96boards/96boards-sensors/320030164_2x20P插件排母_规格书1.pdf

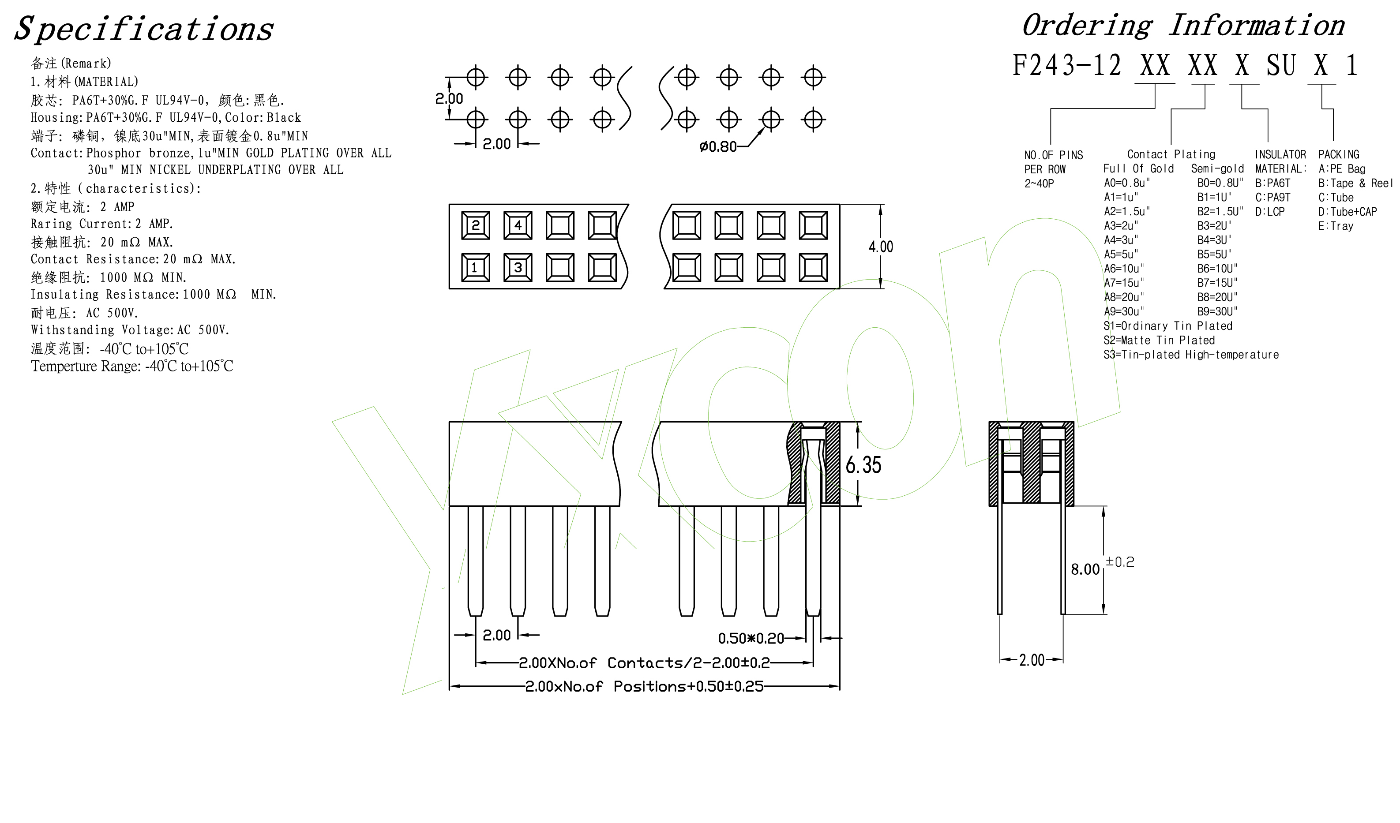
[picture p1: page 1]
