96boards/96boards-sensors/Sensors-bom-test.xlsx

Sheet: BOM
Bill of Materials
96Boards Sensors Rev C |  | Nov 29 2015
Reference | Qty | Value | Footprint | Mfr | Mfr Part # | Seeed SKU
C10 C11 | 2 | 39p | Capacitors_SMD:C_0603 | Yageo | CC0603JRNPO9BN390 | 302010126
C3 C5 C6 C7 C12 C13 C14 C15 C16 C17 | 10 | 100n | Capacitors_SMD:C_0603 | Yageo | CC0603KRX7R9BB104 | 302010138
C18 C19 C22 | 3 | 10u | Capacitors_SMD:C_0805 | Yageo | CC0805KKX5R8BB106 | 302010178
C1 C2 C4 | 3 | 2u2 | Capacitors_SMD:C_0805 | Yageo | CC0805KKX7R8BB225 | 302010148
C8 C9 | 2 | 22p | Capacitors_SMD:C_0603 | Yageo | CC0603JRNPO9BN220 | 302010143
CON1 | 1 | CONSOLE | Sensors:USB_MICRO_B_ST-USB-001E | SUNTECH | ST-USB-001E | 320010015
D1 | 1 | RESET | LEDs:LED-0603 | Everlight | 19-217-BHC-ZL1M2RY-3T | 304090045
D8 | 1 | PB5 | LEDs:LED-0603 | Everlight | 19-217-R6C-AL1M2VY-3T | 304090042
D2 | 1 | PWR | LEDs:LED-0603 | Everlight | 19-217-G7C-AN1P2-3T | 304090043
G1 D3 I2C0 P9 | 4 | GROVE | Sensors:Grove_SMD_Connector | Taifeng | 1125R-SMT-4P | 320110032
A0 A1 G2 A2 G3 G4 D4 D5 D6 D7 I2C1 P8 P13 P14 | 14 | GROVE | Sensors:Grove4P | Taifeng | 1125S-4P | 320110033
IC1 | 1 | ATMEGA328P | Housings_QFP:TQFP-32_7x7mm_Pitch0.8mm | Atmel | ATMEGA328P-AU | 310010049
P1 | 1 | CONN_02X20 | Sensors:Socket_Strip_SMD_2x20_Pitch2mm | Yxcon | F243-1220xxxSUx1 w/ 8mm Pins
P2 P5 | 2 | CONN_01X08 | Socket_Strips:Socket_Strip_Straight_1x08 | Yxcon | F185-1108A1BSYA1 | 320030003
P3 | 1 | CONN_01X10 | Socket_Strips:Socket_Strip_Straight_1x10 | Yxcon | F185-1110A1BSYA1 | 320030039
P4 | 1 | CONN_01X06 | Socket_Strips:Socket_Strip_Straight_1x06 | Yxcon | F185-1106A1BSYA1 | 320030004
P6 P7 | 2 |  | Pin_Headers:Pin_Header_Straight_2x03 | Yxcon | P125-1203A0BS116A1 | 320020003
Q1 | 1 | S8050 | Sensors:SOT-23_Seeed | JCET | S8050 | 305010017
Q2 Q3 Q4 Q5 | 4 | BSS138 | Sensors:SOT-23_Seeed |  |  | BSS138
R11 R12 | 2 | 220R | Sensors:R_0603_Seeed | Yageo | RC0603JR-07220RL | 301010163
R2 R3 R4 | 3 | 1K | Sensors:R_0603_Seeed | Yageo | RC0402JR-071KL | 301010006
R5 R7 | 2 | 620R | Sensors:R_0603_Seeed | Yageo | RC0603JR-07620RL | 301010210
R8 R10 | 2 | 22R | Sensors:R_0603_Seeed | Yageo | RC0603JR-0722RL | 301010289
R1 R6 R9 R16 R17 R18 R19 R23 R24 R25 R26 | 11 | 10K | Sensors:R_0603_Seeed | Yageo | RC0603FR-0710KL | 301010299
S1 S2 | 2 | PWR RST | kicad-gcl:SW_PUSH_B3U_1000P | Omron | B3U-1000P-2P-SMD | 311020047
U1 | 1 | CJT1117-3.3 | Sensors:SOT223 | Jiangsu Changjiang | CJT1117-3.3 | 310030097
U2 | 1 | XC6206 | Sensors:SOT-23_Seeed | Torex | XC6206P182MR | 310030016
U3 | 1 | FT230XS | Housings_SSOP:SSOP-16_3.9x4.9mm_Pitch0.635mm | FTDI | FT230XS-R | 310070030
U4 | 1 | TXB0108PW | Housings_SSOP:SSOP-20_4.4x6.5mm_Pitch0.65mm | TI | TXB0108PW | 310050024
U5 | 1 | TXS0108E | Housings_SSOP:SSOP-20_4.4x6.5mm_Pitch0.65mm | TI | TXS0108EPWR | 310050026
X1 | 1 | 16MHz | Sensors:Crystal_3.2X5_SMD | Jingpengyuan | X053201602002 | 306010054
- | 8 | M2.5 screw
- | 4 | M2.5 8mm threaded spacer
 |  |  |  | Note | Select components as appropriate for cost reductions
 |  |  |  |  | Seeed OPL components have been selected where possible

Sheet: PCB
PCB Spec
96Boards Sensors Rev C
Material | Standard FR-4
Size | 85mm x 54mm
PCB Layers | 2
Thickness | 1.6mm
Copper Weight | 1 oz
PCB Color | Green
Silkscreen | White – Topside only
Solder Mask | Via mask close
Minimum trace | Per gerber file
Minimum hole size | Per gerber file
Special requirements

Sheet: Test
Test Procedure
96Boards Sensors Rev C
Manufacturing and Test Procedure
Manufacturing
Ensure that all through hole component pins on the bottom of the board are cropped to less than 1mm
Teminology
UUT | “Unit Under Test” - Refers to the 96Boards Sensor board
96Boards Sensors Test Jig
Parts
2x20 2mm socket – Mates with UUT P6
DPDT switch
Power Supplies for +5V and +1.8V
Pogo pins or equivalent to mate with J1
Design
Create a 2x20mm header to connect to P6 wired as follows (Schematic also included below)
Pin 1 | GND
Pin 2 | GND
Pin 5 (U0 TX) | Wired to DPDT pin 6
Pin 7 (U0 RX) | Wired to DPDT pin 3
Pin 11 (U1 TX) | Wired to DPDT pin 2
Pin 13 (U1 RX) | Wired to DPDT pin 5
DPDT Pin 1 | Shorted to DPDT Pin 4
DPDT Pin 4 | Shorted to DPDT Pin 1
Pin 15 (SCL0) | Short to pin 23
Pin 17 (SDA0) | Short to pin 24
Pin 19 (SCL1) | Short to pin 25
Pin 21 (SDA1) | Short to pin 26
Pin 23 (GPIOA) | Short to pin 15
Pin 24 (GPIOB) | Short to pin 17
Pin 25 (GPIOC) | Short to pin 19
Pin 26 (GPIOD) | Short to pin 21
Pin 35 | Supply +1.8V
Pin 37 | Supply +5V
Pin 39 | GND
Pin 40 | GND
Short together the two pads on J1.
DPDT position labels
“Loopback” | DPDT position 0 – UART1 TX looped to UART1 RX
“Arduino” | DPDT position 1 – UART0 crosswired to UART1
Test Plan
a. | Select “Loopback” position on DPDT switch
b. | Connect UUT to test jig
c. | Verify UUT LED D2 (PWR) is lit
d. | Connect PC to UUT USB port (CON1)
e. | Using FTDI FT_PROG utility, flash provided template configuration into UUT's FT230X device
f. | Program Arduino UNO bootloader onto ATMEGA328 using ISP header
g. | Using serial terminal emulator on PC, verify serial data sent is looped back
h. | Select “Arduino” position on DPDT switch
I. | Verify Arduino IDE can load the “BlinkAll” sketch onto the board and it causes the PB5 LED to flash
j. | Connect GROVE LED modules to connectors D3-D7, A0-A2, A6 and I2C-AT. 10 modules in all (or use a single module to test each connector one at a time.)
Note: | Seeed's regular GROVE LED modules only use a single GPIO signal on the GROVE connector. For complete testing we would want a Grove module with 2 LEDs so that both signals get tested.
k. | Verify all LEDs on GROVE modules are flashing.
l. | Connect GROVE cable from D3 to GPIO1
m. | Connect GROVE cable from D5 to GPIO2
n. | Verify UUT LEDs are flashing: D1 & D2 (GPIOs A & B)
o. | Connect GROVE LED modules to P13 and P20
p. | Verify all LEDs on GROVE modules are flashing
FT_PROG | http://www.ftdichip.com/Support/Utilities.htm
