96boards/96boards-sensors/Sensors.pdf

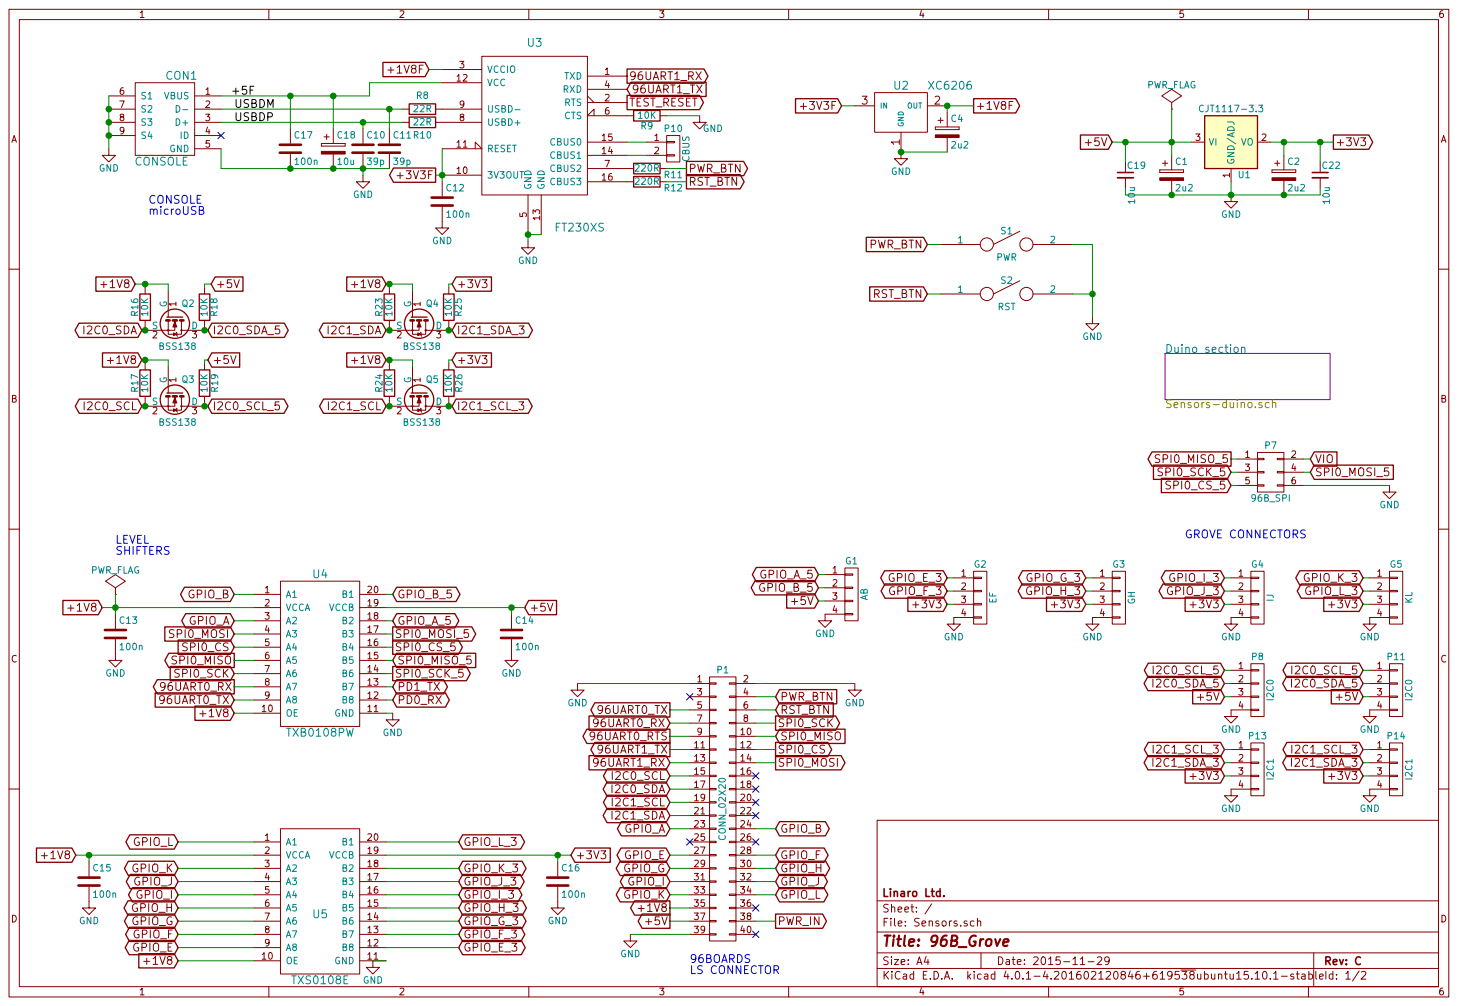
[picture p2: page 1]

I2C1_SDA_3 Duino section Sensors-duino.sch GND 1

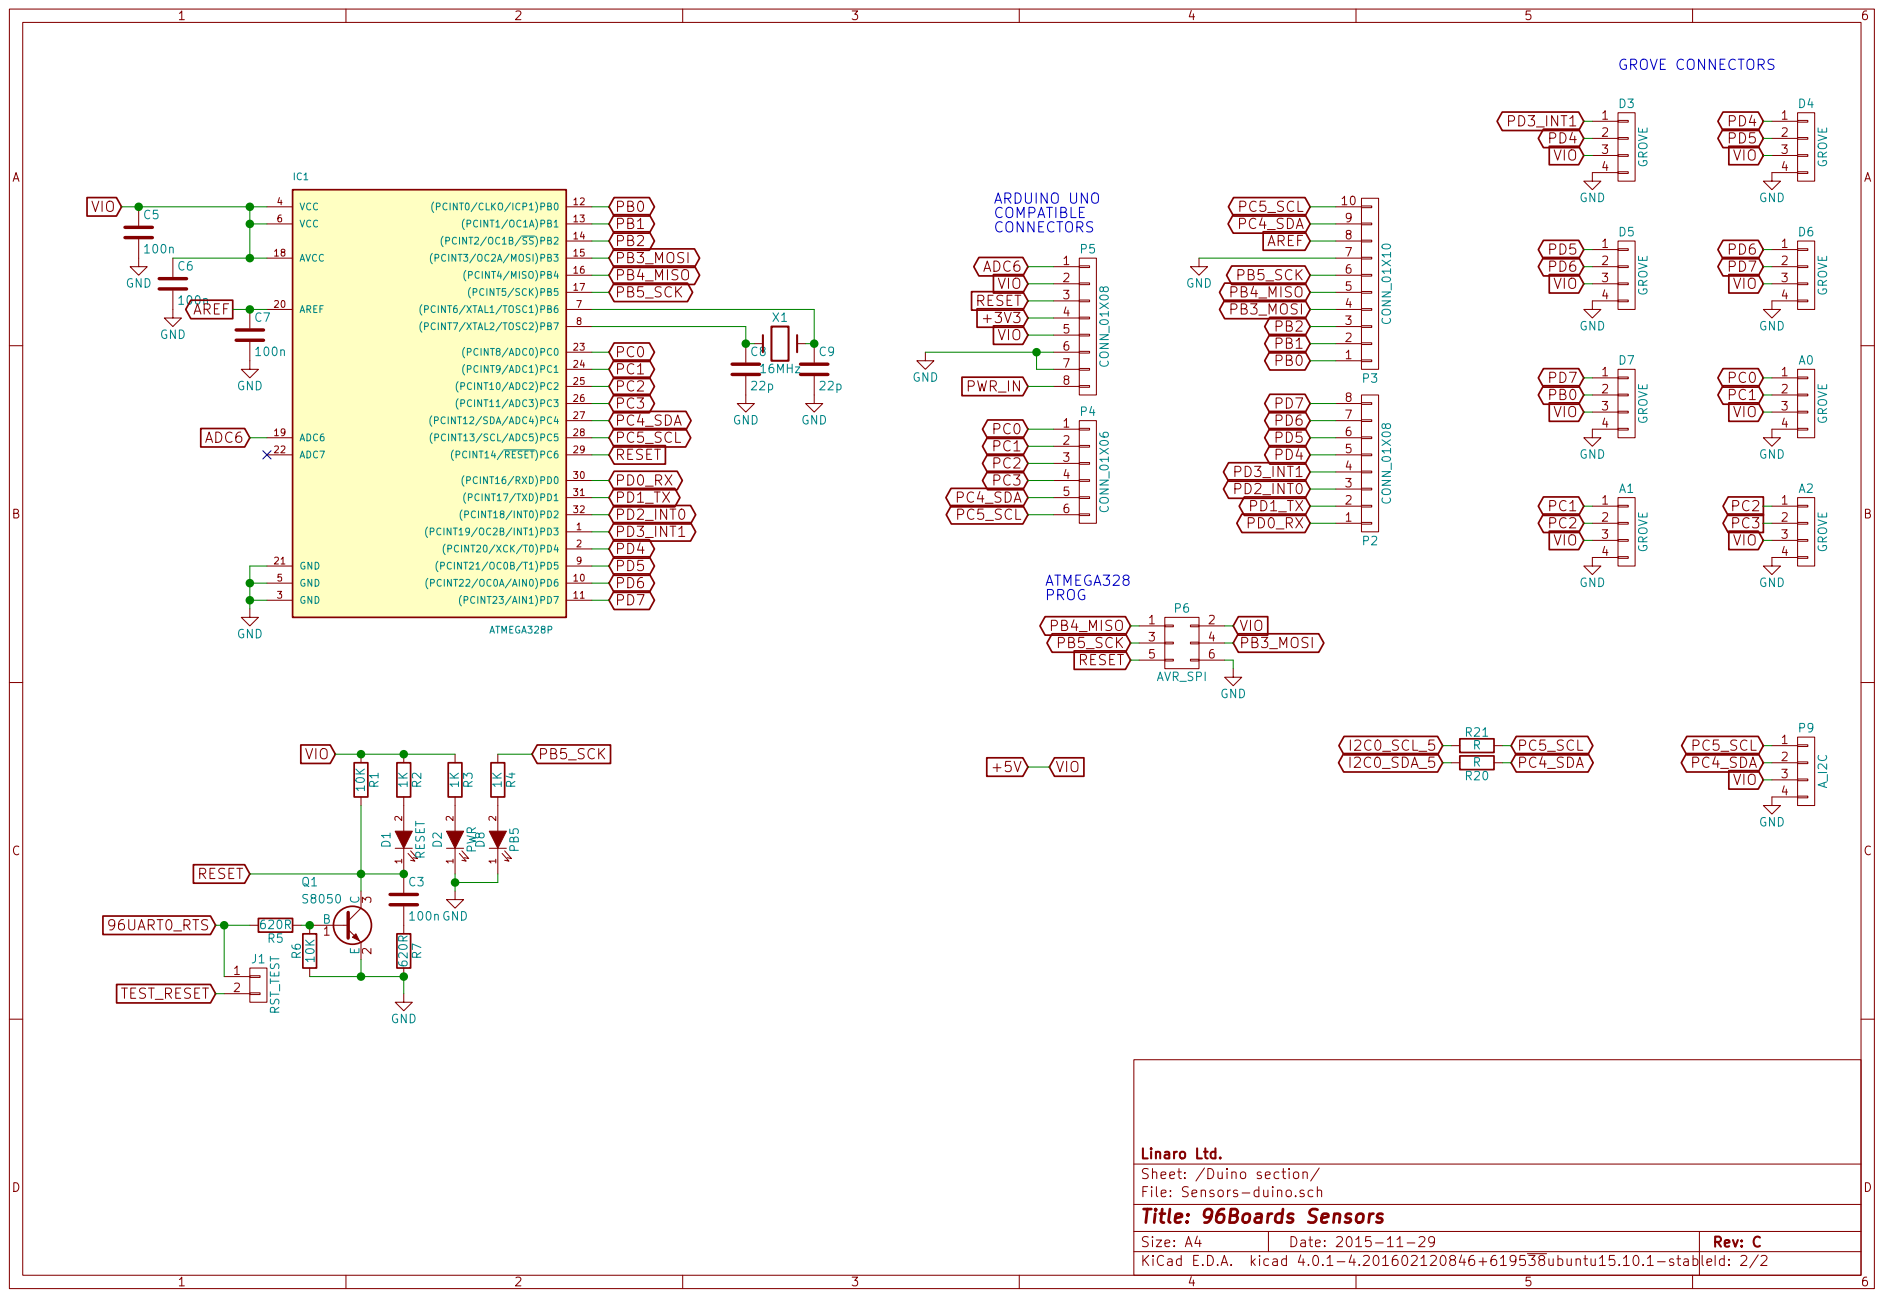
[picture p3: page 2]

File: Sensors-duino.sch Sheet: /Duino section/ Linaro Ltd.
