96boards/96boards-sensors/Sensors-layout.pdf

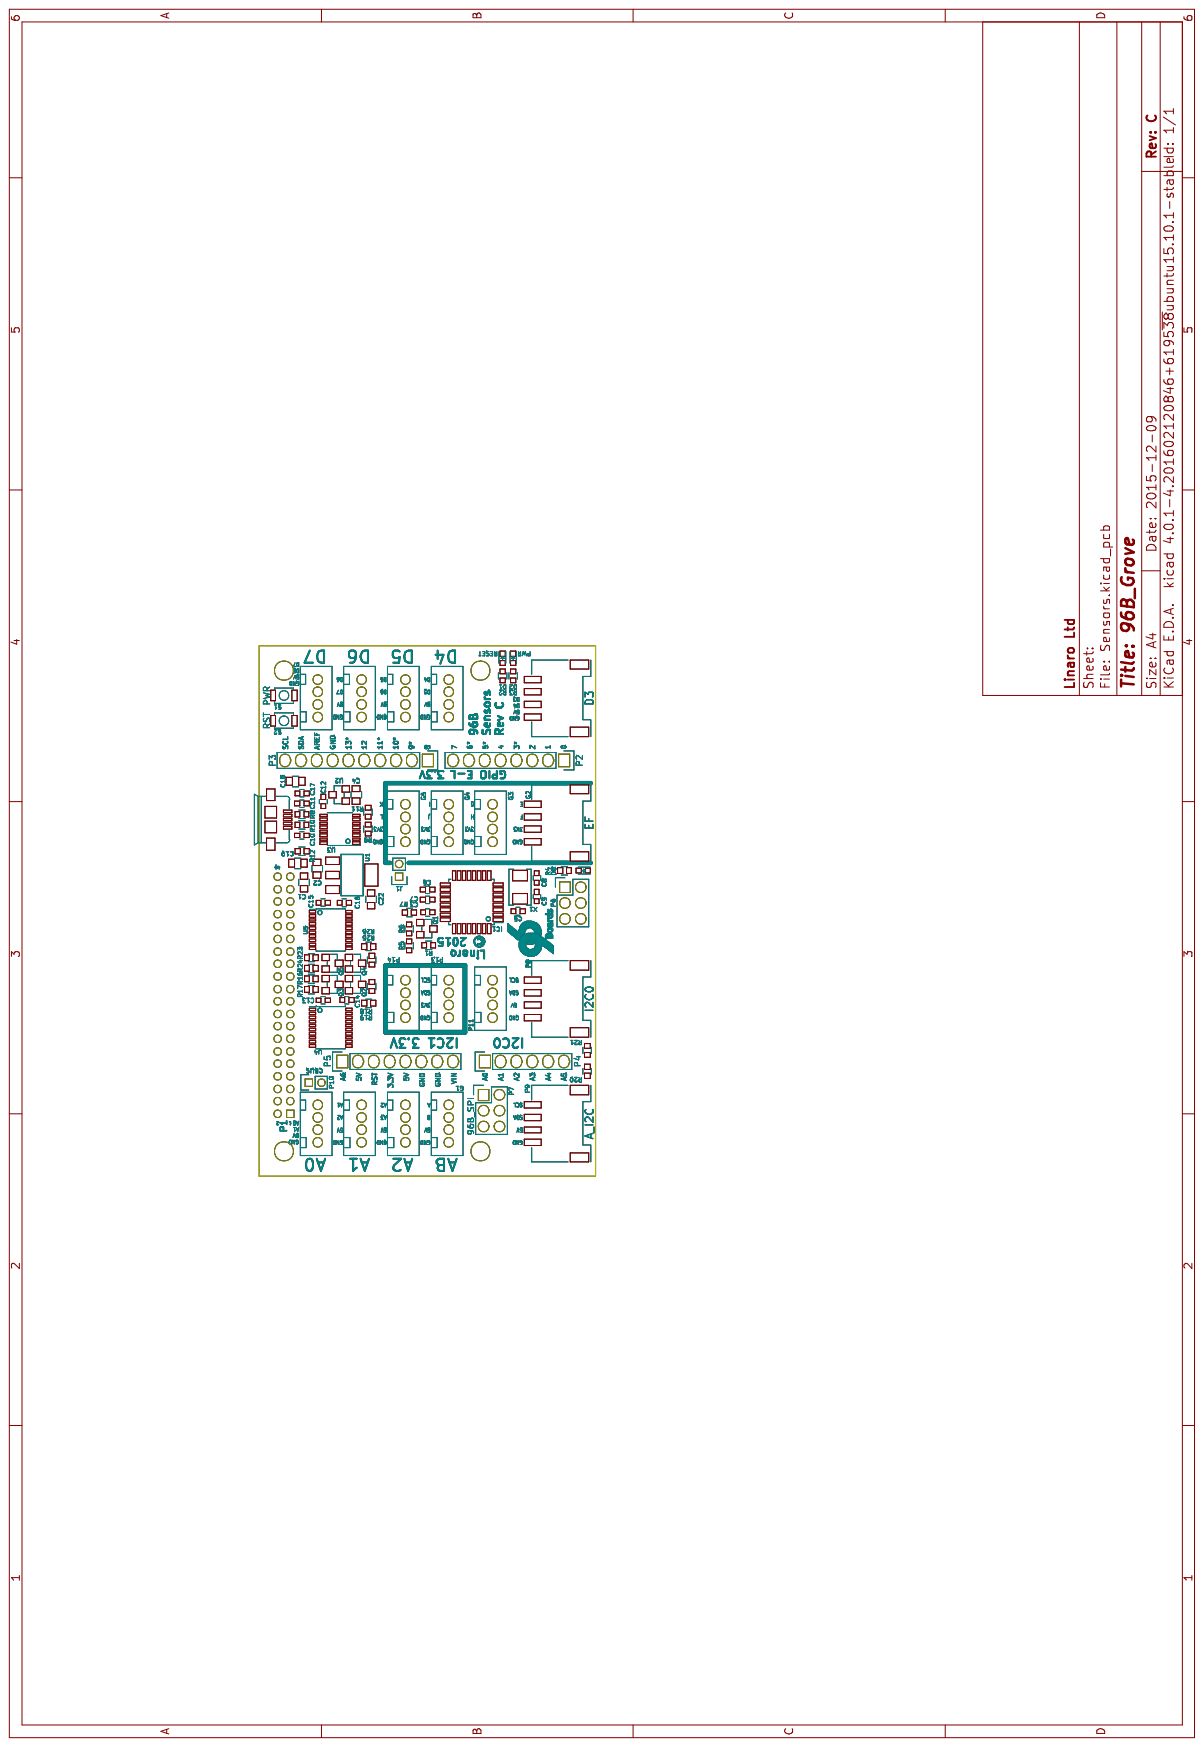
[picture p4: page 1]
