96boards/96boards-sensors/(commit log)

2015-08-12 Initial import of George's design files
    [Sensors.kicad_pcb, Sensors.sch]
2015-08-13 Add in release candidate from Aug 13
    [Sensors.kicad_pcb, Sensors.sch]
2015-08-13 Put label names into schematic
    So that updating the netlist doesn't reset all the values
    [Sensors.kicad_pcb, Sensors.sch]
2015-08-13 Put part number details into schematic
    So that the BOM can be auto-generated. I've put the values in from what
    is listed in the BOM file as provided to Seeed, but I've not verified
    that it is all correct.
    [Sensors.sch]
2015-08-14 Update Makefile to build manufacturing .zip correctly
    Needed to add the Seeed BOM and the FT230x programming file.
    [Sensors-bom-test.xlsx]
2015-08-14 Change layer selection for manufacturing outputs
    [Sensors.kicad_pcb]
2015-08-14 Make i2c busses bidirectional
    Because they are
    [Sensors.sch]
2015-08-14 Add MOSFET level shifter and split v1.8 rail
    The MOSFET provides level shifting for the RTS line. The RTS line
    provides the reset signal for the Atmel processor.
    The 1.8V rail needed to be split so that the FT230X chip works correctly
    regardless of the order the board is powered up. Without it the board
    would need to be powered up before the USB cable is plugged in.
    [Sensors.kicad_pcb, Sensors.sch]
2015-08-14 Add tool for generating collated BOM
    XSLT is not easy to figure out. This is a pretty ugly hacked up script
    to generate a BOM with all the identical components collated into a
    single line item.
2015-08-14 Fixup part numbers in schematic
    [Sensors.sch]
2015-08-15 Switch back to using a transistor for Arduino reset
    The RTS reset pulse sent by avrdude is active high, not active low, so
    switch back to a transistor circuit for doing the level shifting.
    [Sensors.kicad_pcb, Sensors.sch]
2015-08-17 Switch transistor schematic symbol to BC817
    The part is still an S8050, but we want to use the SOT-23 footprint
    instead of TO-92. The default Kicad libraries don't have a SOT-23
    version of the S8050, but it does have one for the BC817 which uses the
    same pinout. Switch the schematic symbol so that KiCad stops complaining
    about the footprint being different and needing to be "rescued"
    [Sensors.sch]
2015-08-17 Add library for project footprints.
    Adds a kicad library for the non-standard footprints used by this project
2015-08-17 Get rid of "Sensors2" library
    All of the footprints are stored in the "Sensors" library. The extra
    "Sendors2" library is no longer needed. Replace all references to it
    with "Sensors".
    [Sensors.kicad_pcb, Sensors.sch]
2015-08-17 Change resistor footprint for Seeed manufacturing
    The default resistor footprint doesn't work for Seeed. Replace with the
    footprint used on the UART board.
    [Sensors.kicad_pcb, Sensors.sch]
2015-08-17 Fix misplaced silkscreen labels
    R2 and C3 labels were in the wrong places. Fix them. Also remove an
    obsolete polarity marker on C11.
    [Sensors.kicad_pcb]
2015-08-17 Update ATMEGA label in layout file
    An earlier commit fixed an incorrect specification on the ATMEGA part
    (it specified the -M variant, but we're using the -AU variant), but the
    layout file didn't get updated. Fix it.
    [Sensors.kicad_pcb]
2015-08-17 Remove the back silkscreen from the gerber set.
    We're not printing the back silkscreen, so don't generate it.
    [Sensors.kicad_pcb]
2015-08-17 Update copper fills
    Update the copper fill. Only change should be due to the new resistor footprint.
    [Sensors.kicad_pcb]
2015-08-17 Move gerber file generation in to a subdirectory
    Putting all the gerbers into a sub directory makes is easier to clean
    out the generated files.
    [Sensors.kicad_pcb]
2015-08-17 Check in designs files as submitted to manufacturing
    [96boards-sensors-bom-test.xlsx]
2015-08-17 Add netclass for power rails
    [Sensors.kicad_pcb]
2015-08-17 Cleanup tracks and vias
    Make sure the tracks are properly connected, nicely aligned and not duplicated.
    [Sensors.kicad_pcb]
2015-08-17 Fix incorrect part specifier for 3.3V regulator
    The V3.3 regulator is a CJT1117, not an S8050
    [Sensors.kicad_pcb, Sensors.sch]
2015-08-18 Update part numbers in schematic for BOM generation
    [Sensors.sch]
2015-08-18 Respond to comments from Seeed DFM - Aug 18, 2015
    George's fixes for the issues from Seeed:
    - Add pin 1 markers to IC footprints
    - Fix fiducials solder mask size
    - Widen power rails
    - Resize logos so they don't blurr
    [Sensors.kicad_pcb]
2015-08-18 Cleanup tracks and vias
    Two minor fixups, plus perform area fill and DRC
    - Straighten crooked PB1 trace
    - Fix width on SCL trace
    [Sensors.kicad_pcb]
2015-09-04 Update test plan to be more specific
    Clarify the test plan to spell out exactly how the test jig should be
    built and specify how to program the Arduino without a 1.8V FTDI cable.
    Also add a procedure for testing the Grove connectors by using an
    Arduino test sketch on the ATMEL.
    [96boards-sensors-bom-test.xlsx]
2015-09-06 Add Arduino sketch to blink all the LEDs
    For testing. Verifies the Arduino signals.
2015-09-08 Update test program to exercise the UART
    Just in case upload doesn't work with the UART, exercise the UART using
    the test sketch.
    [BlinkAll.ino]
2015-09-08 Fix testplan for missing connector tests
    Fix the test plan to better test the Grove connectors. The A0 to A6
    Arduino pins were not getting exercised. Also, the 96B pins were not
    getting effectively tested. Update the test sketch to include the A0 to
    A6 pins, and update the testplan to match.
    [96boards-sensors-bom-test.xlsx]
2015-09-24 Remove the switch
    [Sensors.sch]
2015-10-04 Add SMD 90d Grove connector, and add model to through-hole version
2015-10-06 Rewire PB5 LED to drive high to light and use a 1K resistor
    The first rev had the LED tied to +5V, and PB5 needed to pull it low to
    light. This doesn't play well with USBTinyISP because it puts too much
    load on the line for the programmer to actually program the Arduino, and
    it is opposite to the way the led is wired on every other Arduino. Fix
    it to be consistent with the rest of the Arduino world.
    [Sensors.sch]
2015-10-06 Move the SPI connector to the correct place for Arduino
    For more compatibility with Arduino shields, the SPI connector should be
    in exactly the same place.
    [Sensors.kicad_pcb]
2015-10-06 Add labels for SPI and all the GPIOs
    No functional change, just put the labels in so that they can be used in
    a later change.
    [Sensors.sch]
2015-10-06 Remove UART Grove connectors
    The Arduino UART signals are hard-wired to the LS UART anyway, so it
    cannot really be used for any other purpose. Remove the Grove connector
    for the UART. If someone really wants to use a UART module, there is the
    option to do a soft UART.
    [Sensors.sch]
2015-10-08 Proposed rework of sensors board for revB
    Lots of changes to the schematic:
    - Replace level shifters to 8 channel variants to get more 96board IO
    available
    - Level shift the SPI signals
    - Remove two of the user LEDs
    - Add Grove connectors for additional two lines of GPIO
    - Add pull-up resistors to I2C bus
    - Rename Grove connectors to reflect the signal names
    - Choose some grove connectors for front-edge 90 degree SMD connectors
    - Add connector for FTDI CBUS[0,1] signals. May be useful for twiddling
    boot select pins
    - Add a library for components used in this design
    [Sensors.sch]
2015-10-09 Replace '/' with '_' in signal names
    KiCad gets confused when '/' is used in a signal name. The layout editor
    cuts off everything before the '/'. Replace it with underscore which
    works much better.
    [Sensors.sch]
2015-10-18 Tweak Grove connectors and create VIO rail
    Tweaks the selection of Grove connectors to match the layout of the
    board. At the same time, allow the IO voltage to be selectable between
    3.3V and 5V via a solder jumper. The Atmel will happily run at a lower
    voltage level, and an awful lot of devices run at 3.3V these days.
    [Sensors.sch]
2015-10-18 New layout for Rev B
    Lots of changes, just about everything has moved, even if just a little
    bit. New layout has far more regular placement of components.
    [Sensors.kicad_pcb]
2015-10-19 Add ADC6/7 Grove connector and test reset jumper to schematic
    Adds one more Grove connector to break out ADC6 & ADC7. At the same time
    add a jumper to allow the FTDI to reset the Arduino, which is useful for
    programming the board during manufacturing test.
    Only changes the schematic. Layout comes later
    [Sensors.sch]
2015-10-19 Layout the new Grove connector
    Adds in the new A6 Grove connector and the reset test jumper.
    [Sensors.kicad_pcb]
2015-10-20 Renumber components
    The components weren't numbered in any kind of logical way. Renumber
    them all to make it easier to find connectors when looking at the Grove
    connectors.
    [Sensors.kicad_pcb, Sensors.sch]
2015-10-20 Adjust placement of layout on sheet to be on an even mm boundary
    It's easier to check dimensions when the board origin is on an even
    boundary. It's a trivial thing, but it makes looking at the layout
    nicer.
    [Sensors.kicad_pcb]
2015-10-20 Tidy up fill zones to line up on mm boundaries
    The fill zones seemed to be pretty ragged. Neaten them up to be back 1mm
    from the edge of the board all the way around.
    [Sensors.kicad_pcb]
2015-10-20 Update silkscreen and dimension drawings
    Update all of the component label placement so that they can actually be
    read. Also update the dimensions for reference.
    [Sensors.kicad_pcb]
2015-10-20 Update design files as "rev B" and create pdfs
    [Sensors.kicad_pcb]
2015-10-20 Add labels to Grove signals
    The board is easier to use when everything is labelled.
    [Sensors.kicad_pcb]
2015-10-20 Use connector name for component references
    By using the component name as the reference (ex. A7 instead of P10)
    there can be fewer labels on the silkscreen. Where possible, change the
    connector references to the connector name.
    [Sensors.kicad_pcb, Sensors.sch]
2015-10-22 Switch to through-hole 2x20 connector
    We want to use a stackable connector on the 40pin LS connector, and
    through hole is better than SMD for building stackable boards. Switch
    the footprint to a 2mm 2x20 through-hole part.
    [Sensors.kicad_pcb]
2015-10-24 Move Arduino UNO compatible circuit onto a separate sheet
    The schematic sheet was getting really crowded. Move all of the Arduino
    section to another sheet to give some more room.
    [Sensors-duino.sch, Sensors.kicad_pcb, Sensors.sch]
2015-10-27 Add MOSFETs to switch power supply between 3.3V and 5V
    The original design just routed the power rails directly through solder
    jumper pads, but feedback from review suggested that a switch would be
    more friendly to end users. The power rails could have been routed
    directly through a physical switch, but I was concerned about noise on
    the power rails. Instead, add power supply switching by routing the 5V
    and 3.3V rails through a pair of MOSFETs to isolate them from a switch
    or jumper pads.
    [Sensors-duino.sch, Sensors.kicad_pcb, Sensors.sch]
2015-10-27 Pull i2c lines UP, not down
    The schematic was wrong. It was pulling the i2c lines down instead of
    up. Fix both the schematic and the layout.
    [Sensors-duino.sch, Sensors.kicad_pcb, Sensors.sch]
2015-10-27 Add pads for i2c pull ups on the 1.8V side
    It isn't yet known if we'll need them, but add pads for pullup resistors
    on the i2c 1.8V lines. Doing so ensures that we won't need to respin the
    board if the pullups turn out to be required.
    [Sensors-duino.sch, Sensors.kicad_pcb, Sensors.sch]
2015-10-27 Fix up silkscreen by making labels smaller
    Change all the R and C labels, plus a few more, to 0.7 point instead of
    1 to make everything less cramped.
    [Sensors.kicad_pcb, Sensors.sch]
2015-10-27 Fix DRC errors on schematic
    Fix the following problems:
    - Fix missing drive pin on VIO signal. Fixed by added PWR_FLAG component
    - Unconnected labels on GPIO G-L. Fixed by removing labels and replacing
    with no-connect
    [Sensors-duino.sch, Sensors.sch]
2015-10-27 Minor tweaks to silkscreen
    Move some stuff around and add the 96Boards and OSHW logos.
    [Sensors.kicad_pcb]
2015-10-27 Rename I2C connectors "AT-I2C" to distinguish from 96B i2c busses
    [Sensors-duino.sch, Sensors.kicad_pcb]
2015-10-27 Update the Seeed part numbers for generating the BOM
    [Sensors-duino.sch, Sensors.sch]
2015-10-28 Straighten a trace
    Trivial change. Just taking a kink out of a trace
    [Sensors.kicad_pcb]
2015-10-28 Fix errors in part number fields
    Minor changes to the part number fields, and an update to a footprint
    selection
    [Sensors-duino.sch, Sensors.sch]
2015-10-28 Swap out SOT-23 footprint on Q2 and Q3
    Seeed likes bigger pads for these parts. Swap out the footprint
    [Sensors.kicad_pcb]
2015-10-28 Add dimensions for the Arduino connectors
    [Sensors.kicad_pcb]
2015-10-28 Update the layout pdf
    [Sensors.kicad_pcb]
2015-10-28 Update design package
    [96boards-sensors-bom-test.xlsx, Sensors-bom-test.xlsx]
2015-10-29 Space out the MOSFETs better
    They were pretty close. Space them out better so that the power rail
    routing can be cleaner.
    [Sensors-bom-test.xlsx, Sensors.kicad_pcb]
2015-10-29 Change LED resistor values to 1k
    At 5V, a 620ohm resistor makes the LEDs too bright.
    [Sensors-duino.sch, Sensors.kicad_pcb, Sensors.sch]
2015-10-29 Move R13, R14, R17 & 18 to give more room for rework
    These resistors were placed very close to big components and would have
    been difficult to hand-solder or rework. Move the components to better
    locations and adjust the silkscreen to match.
    [Sensors.kicad_pcb]
2015-10-29 Add clearer pin 1 indicators on U1, U2 and U3
    The default SSOP footprint uses a long line above pin 1, but Seeed wants
    a clearer indication. A small circle at pin 1 is more traditional.
    [Sensors.kicad_pcb]
2015-11-04 Remove i2c pullups and add 22 ohm series resistors to reduce noise
    There have been all kinds of problems with noise on the i2c bus, but the
    pull up strength seems to be just fine for the bus speed that we're
    using. Remove the pull up resistors, but put in series resistors to
    reduce the effects of crosstalk on the i2c lines.
    Also, split the data and clock signals so they don't run parallel across
    the whole board. That should also reduce noise.
    [Sensors.kicad_pcb, Sensors.sch]
2015-11-04 Update RevB design package and schematics
2015-11-04 Add logos back onto silkscreen layer
    The OSHW and 96Boards logos were accidentally removed in an earlier commit
    [Sensors.kicad_pcb]
2015-11-05 Update testplan and manufacturing files for revB
    Ready for manufacturing (finally!)
    [Sensors-bom-test.xlsx, Sensors.sch]
2015-11-05 Add a pin1 indicator to the Atmel
    The other ICs had this added a while back. This one got missed. Add it now.
    [Sensors.kicad_pcb]
2015-11-08 Add 10uF to VIO power rail
    I'm a little worried about noise on the power rail. Add a 10uF cap to
    really make sure the rail is clean.
    [Sensors-duino.sch, Sensors.kicad_pcb, Sensors.sch]
2015-11-08 Update manufacturing package
    [Sensors-bom-test.xlsx]
2015-11-28 Reroute i2c lines separately to reduce cross-talk
    The i2c ports have been unreliable at least in part due to crosstalk.
    Reroute them with separation between each line to reduce the problem.
    [Sensors.kicad_pcb]
2015-11-29 Replace TXS0108 level shifters for i2c with PCA9306
    The TXS0108 doesn't work well with long trace lengths on i2c. When there
    is too much capacitive load on the line the integrated one-shot drivers
    go into oscillation and it locks up the bus. Since we cannot make the
    TXS0108 work reliably, use a different part on the i2c lines. The
    PCA9306 is a simpler circuit without the one-shot driver and it works
    reliably on a prototyped bread-board circuit.
    Sadly, the PCA9306 takes up a lot more room because it doesn't have
    integrated pull-up resistors, and there wasn't any more room on the
    board to place the new parts. Drop the switchable voltage levels to get
    back some space at the top of the board wh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
    [Sensors-duino.sch, Sensors.kicad_pcb, Sensors.sch]
2015-11-29 Fix missing caps on FT230X power supply
    The USB power rail decoupling caps were missing for the FT230X part. Add
    them back in.
    [Sensors-duino.sch, Sensors.kicad_pcb, Sensors.sch]
2015-11-29 Update component part numbers
    Make sure the correct part numbers are in the schematic for generating a
    BOM.
    [Sensors-duino.sch, Sensors.kicad_pcb, Sensors.sch]
2015-11-29 Revert bom2csv change on matching value
    Matching the value it important to make sure different components don't
    get collapsed into the same BOM line item. It was initially deleted to
    make creating the BOM easier, but it caused trouble.
2015-11-29 Add VSSOP module and fix solder mask margin
    [Sensors.kicad_pcb]
2015-11-30 Update rev C design files
    [Sensors-bom-test.xlsx, Sensors-duino.sch, Sensors.kicad_pcb, Sensors.sch]
2015-11-30 Change one of the Grove connectors to be GPIO
    GPIO A & B are level shifted, but they weren't exposed anywhere other
    than to drive a couple of LEDs. Repurpose one of the 3.3V I2C connectors
    to be GPIO instead.
    [Sensors-duino.sch, Sensors.kicad_pcb, Sensors.sch]
2015-12-04 Add pads for power and reset switches
    Added pads for tiny reset and power buttons on the edge of the board.
    Moved the CBUS connector to beside A0 to make room.
    [Sensors-duino.sch, Sensors.kicad_pcb, Sensors.sch]
2015-12-06 Switch from pca9306 to bss138 for i2c level shifting
    The BSS138 seems to work better on the breadboard. Switch to that for
    i2c level shifting.
    [Sensors-duino.sch, Sensors.kicad_pcb, Sensors.sch]
2015-12-06 Reroute PWR_IN to stay away from other power signals
    Just to avoid any possibility of a short between +18V and the IO lines
    [Sensors.kicad_pcb]
2015-12-07 Add part numbers for BSS138 mosfets
    Put the part numbers in for creating a BOM
    [Sensors.sch]
2015-12-07 Change component field names to work with kicost
    KiCost will search several distributors to find the BOM cost of
    components, but it depends on certain names for the manufacturer and
    part number fields. Globally change all the names from "Mfr" and "Mfr
    Part #" to "manf" and "manf#" which KiCost will understand.
    [Sensors-duino.sch, Sensors.sch]
2015-12-07 Move the buttons to be in-line with the mounting holes
    Putting S1 and S2 in line with the mounting holes and LS connector gives
    better mechanical support when the buttons are pushed.
    [Sensors.kicad_pcb]
2015-12-10 Rename board from 96Boards Sensors to 96B Grove
    [Sensors.kicad_pcb, Sensors.sch]
2015-12-10 Clean up Ground plane thermal relief connections
    Some of the Ground connections resulted in messy fill. Clean it up so
    all the ground pins are connected in the same way that the pads want to
    be filled.
    [Sensors.kicad_pcb]
2015-12-10 Protect baseboard if Sensors board is installed incorrectly
    Disconnect pins 36 (PWR_IN) and 40 (GND) to protect the baseboard if P1
    gets installed off-by-one. Keeping PWR_IN pins 36 and 38 tied together
    will short +12V directly to GPIO_L (34) or GND (40) if the connector was
    off by one. Having pin 40 attached to GND would cause +12V to be shorted
    directly to the +5V rail. To protect the baseboard, remove these direct
    connections. Using only one PWR_IN pin is more than sufficient for this
    board because it isn't used for anything. There are also three other GND
    pins on the connector rated at 2A each. Dropping one should not be an
    issue.
    These changes don't guarantee to protect the baseboard.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
    [Sensors.kicad_pcb, Sensors.sch]
2015-12-11 Adjust grove connector silk screen
    Make the grove connectors more obvious as to their purpose
    Reported-by: Akira Tsukamoto <akira.tsukamoto@linaro.org>
    [Sensors-duino.sch, Sensors.kicad_pcb, Sensors.sch]
2015-12-11 Update design package for rev-c
    [Sensors-bom-test.xlsx]
2015-12-15 Update silkscreen to make 3.3V connectors really visible
    [Sensors.kicad_pcb]
2015-12-15 Rearrange I2C connectors
    [Sensors-duino.sch, Sensors.kicad_pcb, Sensors.sch]
2016-01-08 Remove unused footprints
    The Rev C version doesn't use any of these footprints. Remove them.
2016-01-18 Remove pca9306 from BOM
    The 9306 level shifter isn't used in the design, so it shouldn't be in the BOM
    [Sensors-bom-test.xlsx]
2016-01-28 Remove D9, D10, R13, and R14 from the BOM
    LEDs D9 and D10 put too much load on the level shifter U4. Remove the
    LEDs so that the GPIO lines become usable.
    [Sensors-bom-test.xlsx]
2016-02-21 Add generated gerber files to project
    Keep the unpackaged gerber files in the repo so it is easier to see what
    has changed in the design package between revision.
    [Sensors-B.Cu.gbl, Sensors-B.Mask.gbs, Sensors-B.Paste.gbp, Sensors-Edge.Cuts.gm1, Sensors-F.Cu.gtl, Sensors-F.Mask.gts, Sensors-F.Paste.gtp, Sensors-F.SilkS.gto]
2016-02-21 Remove GPIO LEDs D9, D10, R13 & R14 and correct silkscreen
    LEDs D9 and D10 don't work, so remove them from the schematic and the
    layout. At the same time correct the board name silkscreen to say "Rev
    C" instead of "V1.2" because all of our material uses the "Rev C"
    designation.
    [Sensors-B.Cu.gbl, Sensors-B.Mask.gbs, Sensors-B.Paste.gbp, Sensors-Edge.Cuts.gm1, Sensors-F.Cu.gtl, Sensors-F.Mask.gts, Sensors-F.Paste.gtp, Sensors-F.SilkS.gto]
2016-02-22 Update pdfs and FTDI programming instructions
    The previous change didn't update the schematic or layout PDFs. Update
    them now.
    Also, the FTDI configuration settings incorrectly set two of the CBUS
    pins as TX/RX LEDs which will cause problems if trying to use CBUS0/1 to
    control boot flow on the baseboard.
2016-11-02 Datasheet for 320030164 P1 2x20 2mm pitch connector
