96boards/96boards-sensors/(notices)

Notices in the files:
Sensors.kicad_pcb:
© 2015
